prognostics-lab/temperature_sensor/(commit log)

2025-01-27 PCB schematic with footprints
    [temperature_sensor.kicad_pcb, temperature_sensor.kicad_sch]
2025-01-27 schematic corrections & pcb routed
    [temperature_sensor.kicad_pcb, temperature_sensor.kicad_sch]
2025-01-27 NanoLab logo & GND stitching
    [temperature_sensor.kicad_pcb]
2025-01-27 gnd stitching between spi tracks
    [temperature_sensor.kicad_pcb]
2025-01-27 Fixed pad size
    [temperature_sensor.kicad_pcb]
2025-01-27 fabrication files
    [temperature_sensor-B_Cu.gbr, temperature_sensor-Edge_Cuts.gbr, temperature_sensor-F_Cu.gbr, temperature_sensor-NPTH.drl, temperature_sensor-PTH.drl, temperature_sensor-job.gbrjob]
2025-02-28 Fixing bug char to string
    [main.ino]
2025-04-10 fixed CS form PT100 module
    [temperature_sensor.kicad_pcb, temperature_sensor.kicad_sch]
2025-04-10 fixed fabrication file
    [temperature_sensor-B_Cu.gbr, temperature_sensor-Edge_Cuts.gbr, temperature_sensor-F_Cu.gbr, temperature_sensor-NPTH-drl_map.gbr, temperature_sensor-NPTH.drl, temperature_sensor-PTH-drl_map.gbr, temperature_sensor-PTH.drl, temperature_sensor-job.gbrjob]
2025-04-25 Modified the firmware to our use case
2025-05-07 Commented out the error prints
    [main.ino]
2025-06-19 Implemented Dallas sensors
